Moeletsi47/cycloconverter/(list of files, drawings)

Other design files:
proteus9_simulation/cyclo.pdsprj
