Moeletsi47/cycloconverter/KiCad_PCB/cycloconverter.kicad_pcb

## KiCad design KiCad_PCB/cycloconverter.kicad_pcb (2026-10-10)

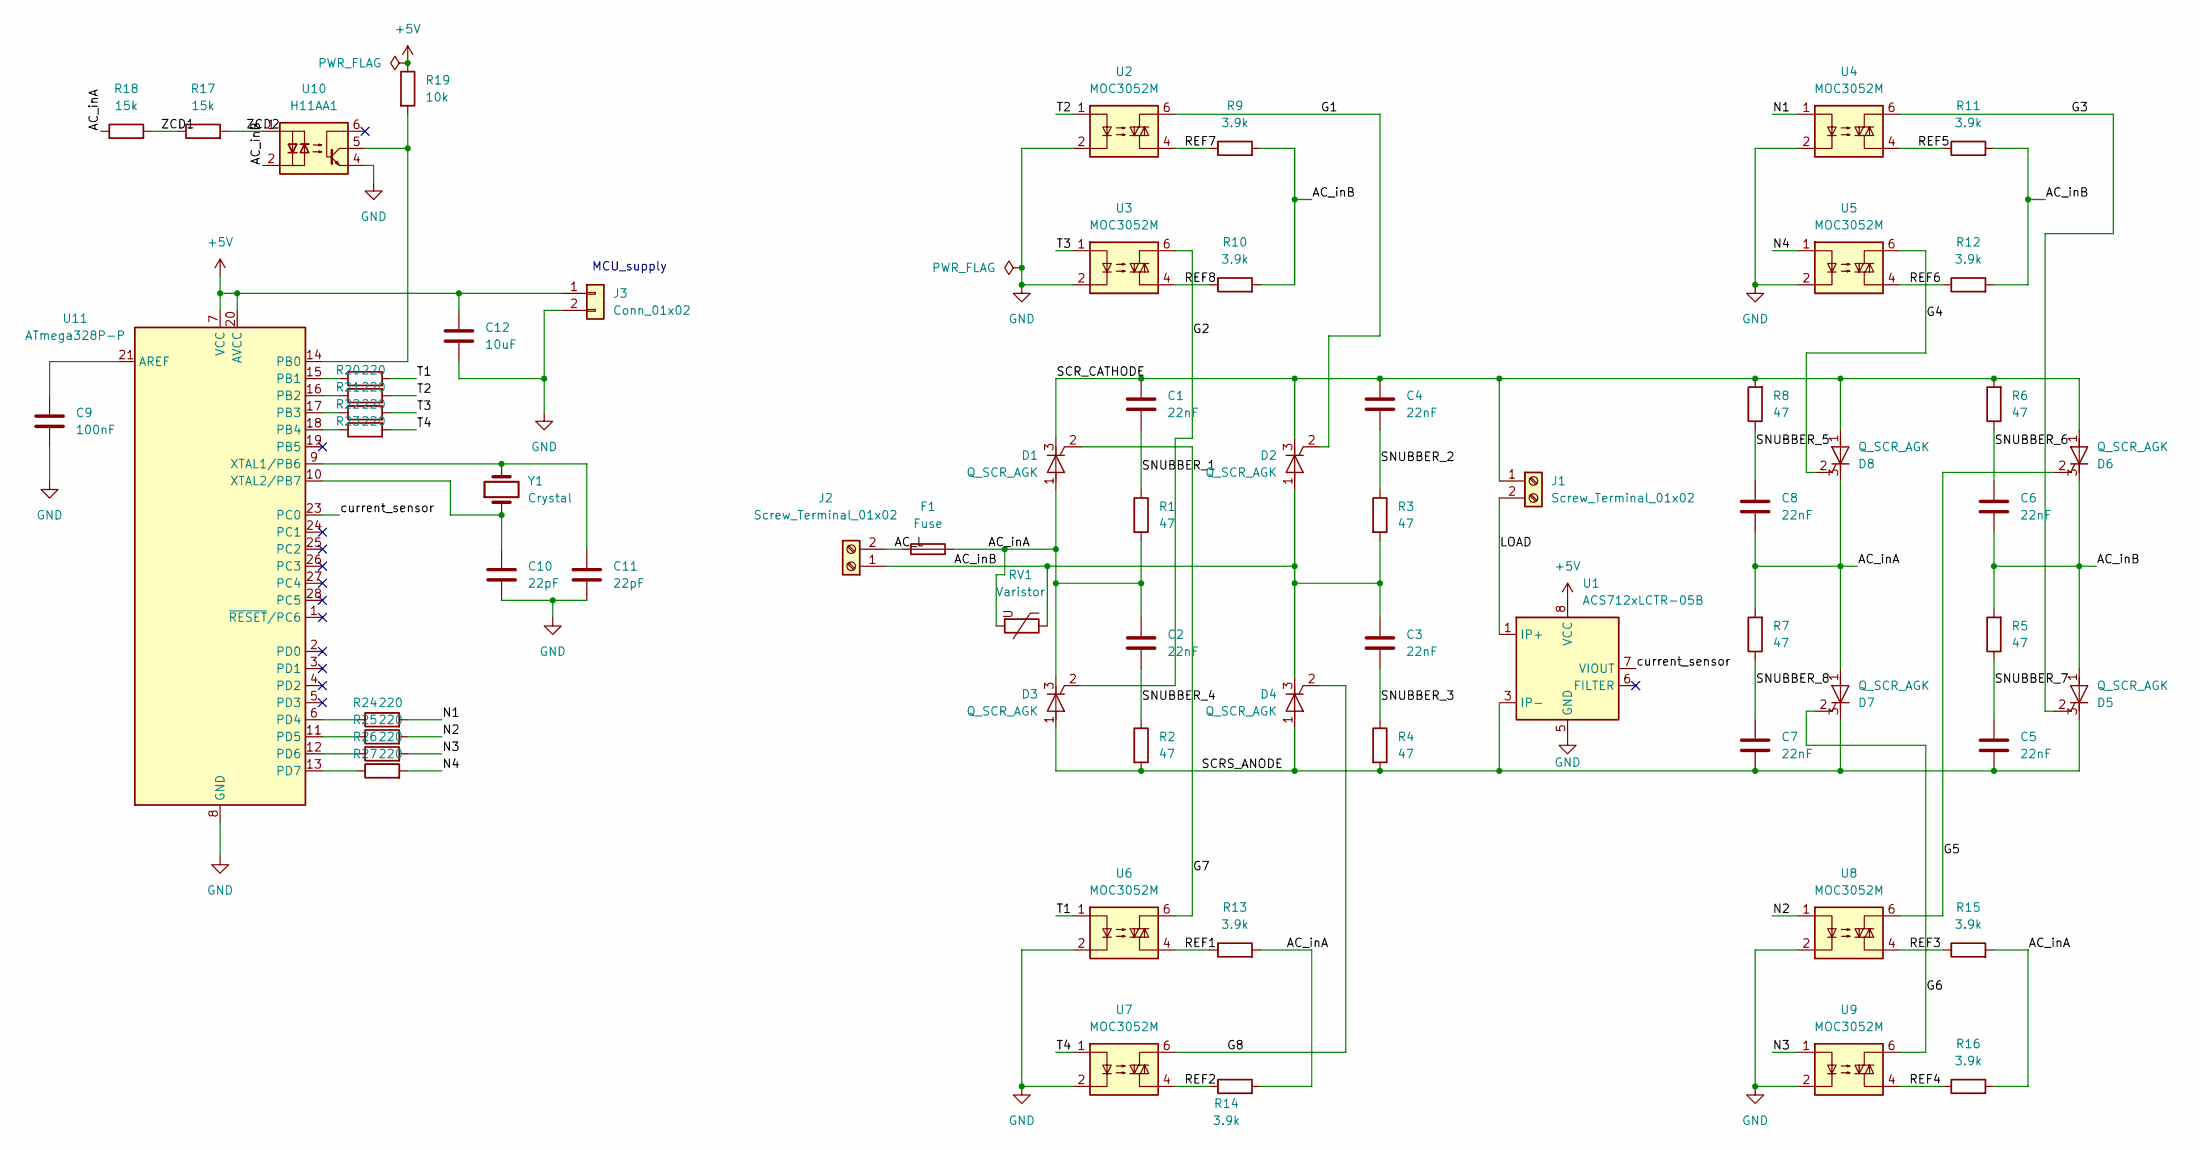
[picture p1: schematic cycloconverter.kicad_sch]

Parts:
C1, C2, C3, C4, C5, C6, C7, C8: 22nF; C_Rect_L18.0mm_W8.0mm_P15.00mm_FKS3_FKP3
C9: 100nF; C_Disc_D4.3mm_W1.9mm_P5.00mm
C10, C11: 22pF; C_Disc_D4.3mm_W1.9mm_P5.00mm
C12: 10uF; C_Disc_D4.3mm_W1.9mm_P5.00mm
D1, D2, D3, D4, D5, D6, D7, D8: Q_SCR_AGK; IFX-PG-TO220-3-904-1
F1: Fuse; Fuseholder_Clip-6.3x32mm_Littelfuse_102_Inline_P34.21x7.62m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
J1, J2: Screw_Terminal_01x02; TerminalBlock_Phoenix_MKDS-1,5-2_1x02_P5.00mm_Horizontal
J3: Conn_01x02; PinHeader_1x02_P2.54mm_Vertical
R1, R2, R3, R4, R5, R6, R7, R8: 47; R_Axial_DIN0516_L15.5mm_D5.0mm_P20.32mm_Horizontal
R9, R10, R11, R12, R13, R14, R15, R16: 3.9k; R_Axial_DIN0414_L11.9mm_D4.5mm_P20.32mm_Horizontal
R17, R18: 15k; R_Axial_DIN0411_L9.9mm_D3.6mm_P12.70mm_Horizontal
R19: 10k; R_Axial_DIN0207_L6.3mm_D2.5mm_P10.16mm_Horizontal
R20, R21, R22, R23, R24, R25, R26, R27: 220; R_Axial_DIN0207_L6.3mm_D2.5mm_P10.16mm_Horizontal
RV1: Varistor; RV_Disc_D15.5mm_W4.3mm_P7.5mm
U1: ACS712xLCTR-05B; SOIC-8_3.81x9.347mm_P2.54mm
U2, U3, U4, U5, U6, U7, U8, U9: MOC3052M; DIP762W46P254L851H508Q6
U10: H11AA1; DIP-6_W7.62mm
U11: ATmega328P-P; DIP-28_W7.62mm
Y1: Crystal; Crystal_HC49-U_Vertical

Connections:
+5V: C12.1, J3.1, R19.1, U1.8 (VCC), U11.7 (VCC), U11.20 (AVCC)
/AC_L: F1.1, J2.2
/AC_inA: C2.1, C8.1, D1.1 (A), D3.3 (K), D7.1 (A), D8.3 (K), F1.2, R1.2, R7.2, R13.2, R14.2, R15.2, R16.2, R18.1, RV1.2
/AC_inB: C3.1, C6.1, D2.1 (A), D4.3 (K), D5.1 (A), D6.3 (K), J2.1, R3.2, R5.2, R9.2, R10.2, R11.2, R12.2, RV1.1, U10.2
/G1: D2.2 (G), U2.6
/G2: D3.2 (G), U3.6
/G3: D5.2 (G), U4.6
/G4: D8.2 (G), U5.6
/G5: D6.2 (G), U8.6
/G6: D7.2 (G), U9.6
/G7: D1.2 (G), U6.6
/G8: D4.2 (G), U7.6
/LOAD: J1.2, U1.1 (IP+), U1.2 (IP+)
/N1: R24.2, U4.1
/N2: R25.2, U8.1
/N3: R26.2, U9.1
/N4: R27.2, U5.1
/REF1: R13.1, U6.4
/REF2: R14.1, U7.4
/REF3: R15.1, U8.4
/REF4: R16.1, U9.4
/REF5: R11.1, U4.4
/REF6: R12.1, U5.4
/REF7: R9.1, U2.4
/REF8: R10.1, U3.4
/SCRS_ANODE: C5.1, C7.1, D3.1 (A), D4.1 (A), D5.3 (K), D7.3 (K), R2.2, R4.2, U1.3 (IP-), U1.4 (IP-)
/SCR_CATHODE: C1.1, C4.1, D1.3 (K), D2.3 (K), D6.1 (A), D8.1 (A), J1.1, R6.2, R8.2
/SNUBBER_1: C1.2, R1.1
/SNUBBER_2: C4.2, R3.1
/SNUBBER_3: C3.2, R4.1
/SNUBBER_4: C2.2, R2.1
/SNUBBER_5: C8.2, R8.1
/SNUBBER_6: C6.2, R6.1
/SNUBBER_7: C5.2, R5.1
/SNUBBER_8: C7.2, R7.1
/T1: R20.2, U6.1
/T2: R21.2, U2.1
/T3: R22.2, U3.1
/T4: R23.2, U7.1
/ZCD1: R17.1, R18.2
/ZCD2: R17.2, U10.1
/current_sensor: U1.7 (VIOUT), U11.23 (PC0)
GND: C9.2, C10.2, C11.2, C12.2, J3.2, U1.5 (GND), U2.2, U3.2, U4.2, U5.2, U6.2, U7.2, U8.2, U9.2, U10.4, U11.8 (GND), U11.22 (GND)
unnamed: C9.1, U11.21 (AREF)
unnamed: R19.2, U10.5, U11.14 (PB0)
unnamed: R20.1, U11.15 (PB1)
unnamed: R21.1, U11.16 (PB2)
unnamed: R22.1, U11.17 (PB3)
unnamed: R23.1, U11.18 (PB4)
unnamed: R24.1, U11.6 (PD4)
unnamed: R25.1, U11.11 (PD5)
unnamed: R26.1, U11.12 (PD6)
unnamed: R27.1, U11.13 (PD7)
unnamed: C11.1, U11.9 (XTAL1/PB6), Y1.2
unnamed: C10.1, U11.10 (XTAL2/PB7), Y1.1

Notes on the sheet:
MCU_supply

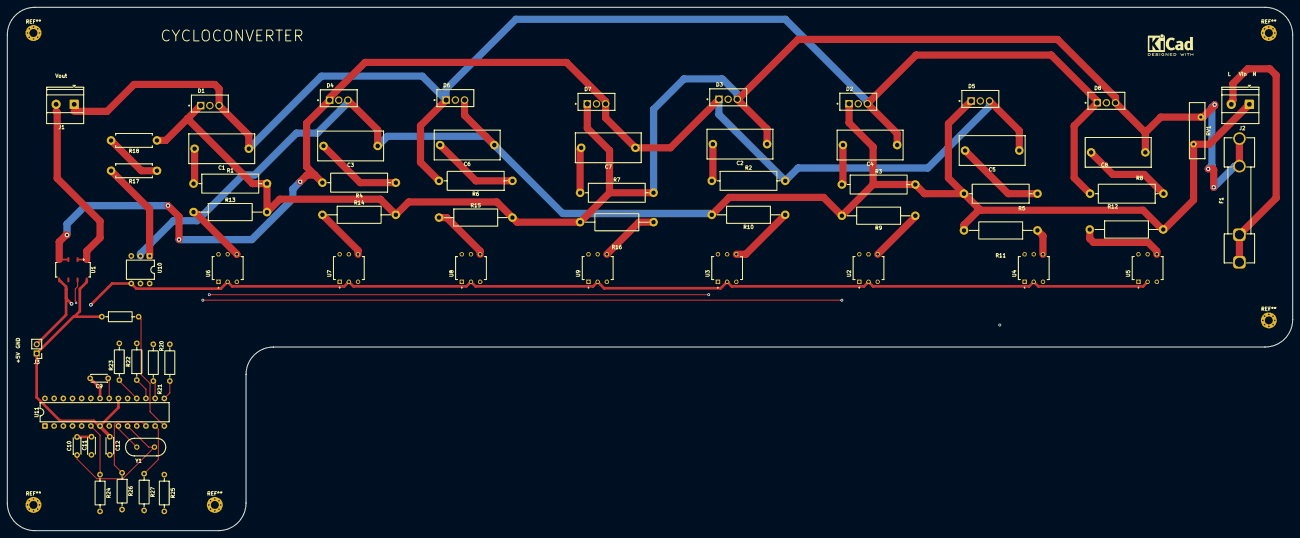
[picture p2: board cycloconverter.kicad_pcb from above]

Board: 4 copper layers, 355.6 x 144.8 mm, 64 parts (0 on the bottom side), 55 nets.
